justinf4/Uncrewed_Aircraft_Water_Sampler/archive/initial_prompt.md

So WSSD optimized is code to run servos from a button press and at the same time take GPS location pull date and time from GPS and then log it to an SD card it also checks the date and time on the GPS and then it creates a file based on the date into the SD code for the CSV file that it creates and so basically the the other code the TR test that is too receive a signal from a transmitter and then that's all that it does just to test that but so I want to combine that with WS optimized and so whenever it receives a signal on the transmitter it acts as that button press what are the models of the models that you use and like what is the model of the receiver what is the model of the GPS what servo specifically are you using like is it 180° servo so it's a continuous rotation servo and so there's also a magnetic there's a read switch in the system so that once it gets to the end of the the movement of the of the rack and pinion system then it tells the servo to stop and then pause for a second and then go back to its original state in which there's another there's two magnets on either side of the rack so it'll go between those two points don't know the models of like the transmitter and stuff because it's working now it doesn't really need to know OK perfect just the code that you have works what is not working or what do you need to get done So what would I need to get done is I need to replace the button press with receiving a signal from the transmitter so every time it receives a signal it it runs the servo and then also I need to be able to alternate between two servos so let's say you press the button one time it'll run servo 1 when you press the button the second time it will run servo 2 but then when you press it a third time it'll go ahead and run sort of a one again and yeah that's it perfect and basically we have Arduino Ino files and we're trying to turn them into a platformio project locally please make it as simple as possible the Arduino board that is being used is and it's an official Arduino nano ESP 32 make sure it's the one from Arduino it's not a regular ESP 32 perfect and then basically we're also going to make a separate folder in the platform wheel project to hold Python scripts so that what we can do is upload this code to do the Arduino nano connected to this computer and then we want to monitor using the serial monitor functionality of platformio using the Python scripts to see if we're getting the correct output or not and make sure to be using the Python scripts to monitor things not actual raw commands because you will fail and you will crash if you don't use a Python scripts and please make a dedicated docs folder inside of the platformio project because we're gonna want to have some reference documentation and i can give templates and guidelines later but i want to keep things as simple as possible for notw and ideally be able to download libraries locally so that we don't have to deal with downloading them from the cloud when we are out in the feel so please feel free to spawn a web reserach agent to Find the libraries for adjacent libraries that we would need to use on Github and document the findings inside of the docs folder that you're going to set up so that we can go and download the zip files and then add it into the lid folder and you can handle it from there does that make sense? feel free to ask any questions as needed

OK so the signal we're receiving the signal and it is properly triggering the writing to the SD card but the Excel file or rather the whoa is it a CSV file yeah so the CSV file it's not making it like once it fixed to the GPS it didn't make a new file name of the date and like when it took samples it didn't record it in in the no date in CSV either OK so it's not recording all the information to the CSV properly and it's not naming the file properly and you want the like the year the month the day 4 minutes 2nd or so in the name of the file it's just a month a day year and then in in the old optimized code it it worked pretty well it's just kind of look at that code and see maybe what changed and make sure that it it all lines up correctly if you already have a file for the days date you want to like add an integer like this is the number one this is number 2 so just increment it yeah that's it's actually set up like that in in the old code so like it reads the file that's already in there for that day and then it sees like oh it's on number 10 now I'm going to start it on number eleven and what data are you expecting to see in the CSV like you want latitude longitude yeah date time that long and temperature and then also on the right on the leftmost column is the the counter but OK what is the counter entail because you have the two different servos so how are you going to differentiate which servo goes to so it's like you mean like with the like the surface and the depth surface what does the counter mean because if you have the day already in the name of the file if we do you want to record all information taken on that day to the same file or to a new file up to the same file so like the name of the file is the date and then each each input has a separate counter on it so like every button press yeah every button press is a counter and then along with that is is the date the time attached to it and then the temperature on the surface the temperature at depth latitude long longitude so we don't actually want to make a bunch of new files if a file already exists for the date we want to keep appending to the same file yeah and then if there's no file for that day then you make a file for that day great do you want to add the red LED indicator for yes so when So when it receives a signal right now it makes the LED green please add a flashing red LED on the onboard LEDS so that while the servos are are running it'll flash red and then once the servo sequence is over it'll stop flashing cool and add when the service sequence is finished please keep the red led on for 1 second so it's like a long flash and then turn it off that's good cool and then document all these ideas and make sure to implement them and update all the documentation once you have everything working as well
