justinf4/Uncrewed_Aircraft_Water_Sampler/docs/wiring schematic/UAWS_SCHEMATIC_REV_B_WHITE.pdf

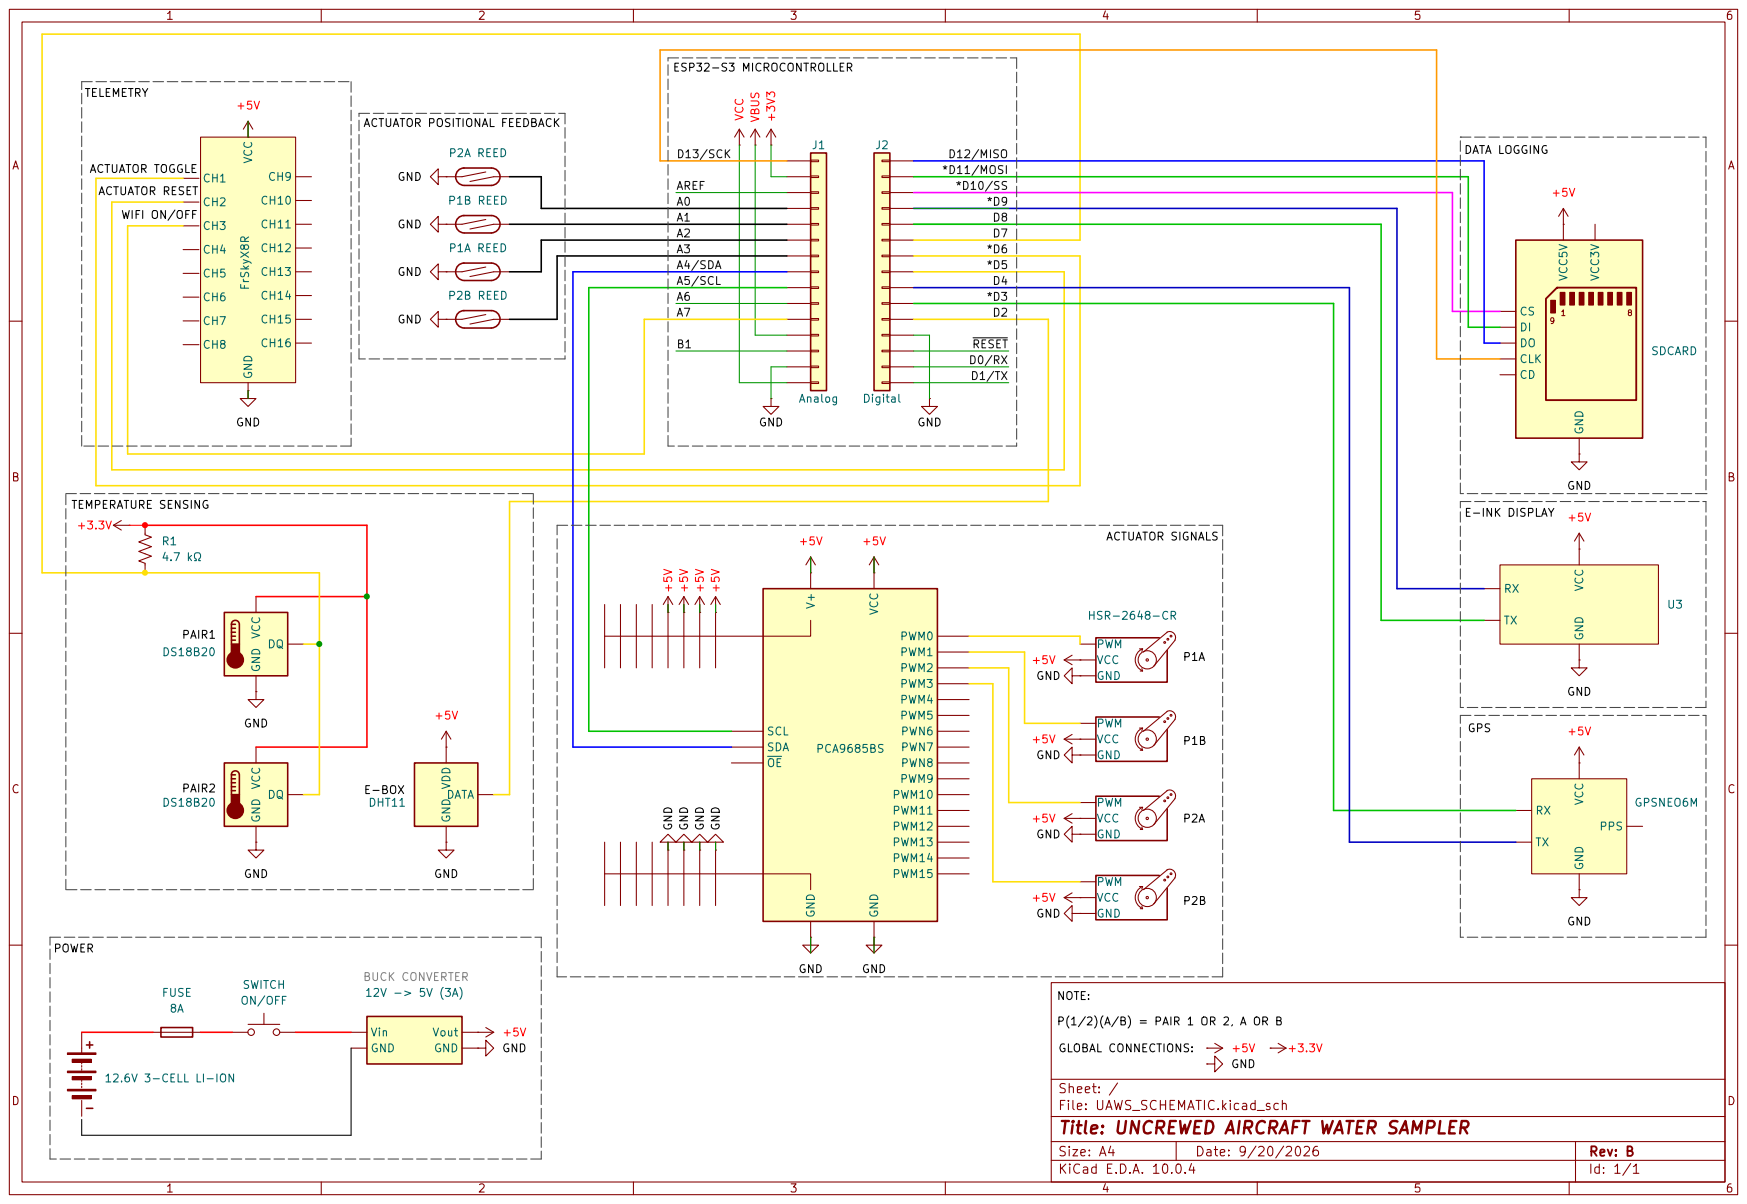
[picture p2: page 1]
