justinf4/Uncrewed_Aircraft_Water_Sampler/src/main_driver_v6.cpp

// ── main_driver_v7.cpp ────────────────────────────────────────────────────────
#include <Wire.h>
#include <Adafruit_PWMServoDriver.h>
#include <TinyGPSPlus.h>
#include <OneWire.h>
#include <DallasTemperature.h>
#include <SD.h>
#include <SPI.h>
#include <dht11.h>
#include <WiFi.h>
#include <WebServer.h>
#include <ESPmDNS.h>

// ── Pins ──────────────────────────────────────
const int SD_CS_PIN    = D10;
const int RECEIVER_PIN = D6;
const int RESET_PIN    = D5;
const int WIFI_PIN     = A7;

const int REED1 = A2;
const int REED2 = A1;
const int REED3 = A0;
const int REED4 = A3;

const int DISP_TX_PIN = D8;
const int DISP_RX_PIN = D9;

const uint8_t CH_S1 = 2, CH_S2 = 1, CH_S3 = 0, CH_S4 = 3;

const int OPEN  = 1000;
const int CLOSE = 2000;
const int STOP  = 1491;

const unsigned long PAUSE_TIME        = 2000;
const unsigned long MAG_IGNORE_TIME   = 2000;
const unsigned long MAX_MOVE_TIME     = 30000;
const unsigned long LED_FLASH_MS      = 150;
const uint32_t      TRIGGER_THRESHOLD = 1800;

// ── WiFi / AP ─────────────────────────────────
const char* AP_SSID = "UAWSampler";
const char* AP_PASS = "uaws1234";

// A7 carries a standard RC PWM signal (1000-2000 us, 50 Hz frame).
// We use pulseIn with a full 25 ms timeout so it always catches the pulse
// regardless of where in the 20 ms frame it is called.
// We only call it every 500 ms, so a 25 ms block is only 5% loop duty.
// A 3-of-5 majority vote across consecutive readings rejects one-shot
// noise spikes (e.g. from servo motor switching transients).
const uint32_t      WIFI_PULSE_TIMEOUT  = 25000; // us - full RC frame
const unsigned long WIFI_CHECK_INTERVAL = 500;   // ms between pulseIn calls

Adafruit_PWMServoDriver pwm = Adafruit_PWMServoDriver();

OneWire oneWire(10);
DallasTemperature sensors(&oneWire);
DeviceAddress SURFACE_ADDR = { 0x28, 0x9C, 0xEB, 0x6F, 0x00, 0x00, 0x00, 0x72 };
DeviceAddress DEPTH_ADDR   = { 0x28, 0x7A, 0x7A, 0x74, 0x00, 0x00, 0x00, 0x3F };

HardwareSerial gpsSerial(2);
TinyGPSPlus gps;
HardwareSerial dispSerial(1);

WebServer webServer(80);
bool wifiActive   = false;

// ── WiFi switch non-blocking state ────────────
// A7 carries a PWM signal from the RC receiver.
bool          lastWifiHigh      = false;
unsigned long lastWifiCheckMs   = 0;
// 3-of-5 vote buffer — stores last 5 raw pulse readings
uint32_t      wifiVoteBuf[5]    = {0, 0, 0, 0, 0};
uint8_t       wifiVoteIdx       = 0;
uint32_t      wifiLastPulse     = 0; // last raw pulse us (logged in heartbeat)

// ── DHT11 ─────────────────────────────────────
#define DHT11PIN D2
dht11 DHT11;
unsigned long lastTempRead = 0;
float ambientTemp          = 23.0f;
int   dynSTOP              = 1491;
int   dynOPEN              = 1000;
int   dynCLOSE             = 2000;

// ── Servo pairs ───────────────────────────────
struct ServoPair { uint8_t chA; int reedA; uint8_t chB; int reedB; };
ServoPair pairs[2] = {
    { CH_S1, REED1, CH_S2, REED2 },
    { CH_S3, REED3, CH_S4, REED4 }
};

struct SnapData { bool valid, hasFix; char date[12]; double lat, lng; };

int           pairMode[2]       = {0, 0};
bool          pairStoppedA[2]   = {false, false};
bool          pairStoppedB[2]   = {false, false};
unsigned long pairPrevMillis[2] = {0, 0};
SnapData      pairSnap[2];

// ── Last sample ───────────────────────────────
struct LastSample {
    bool   valid;
    int    count;
    char   date[12];
    char   time[10];
    bool   hasFix;
    double lat, lng;
    float  surfaceTemp;
    float  depthTemp;
    float  ambientAtSample;
} lastSample = {false};

// ── Display state ─────────────────────────────
int  sampleCount  = 0;
int  displayNumA  = 1;
int  displayNumB  = 2;
bool displayFullA = false;
bool displayFullB = false;
int  servoIndex   = 0;
int  pairSlot[2]  = {0, 1};

bool          sentFull[2]        = {false, false};
bool          pairModeEntered[2] = {false, false};
unsigned long lastHeartbeat      = 0;
unsigned long ledGreenOffAt      = 0;
unsigned long ledRedOffAt        = 0;
unsigned long ledFlashNext       = 0;
bool          ledRedState        = false;
bool          ledBlueState       = false;   // tracks blue LED so we can flash/set it cleanly
bool          lastReceiverHigh   = false;
bool          lastResetHigh      = false;
bool          fixAnnounced       = false;
bool          lastFixState       = false;
char          logFilename[20]    = "/nodate.csv";

// ── Web UI CSS ────────────────────────────────
static const char* CSS = R"(
  *{box-sizing:border-box;margin:0;padding:0;}
  body{font-family:'Courier New',Courier,monospace;background:#d4d0c8;color:#000;font-size:13px;}
  .hdr{background:linear-gradient(90deg,#000080,#1084d0);padding:10px 14px 8px;
       border-bottom:2px solid #ffcc00;}
  .hdr h1{color:#fff;font-size:13px;font-weight:700;letter-spacing:0.5px;margin:0;line-height:1.3;}
  .hdr p{color:#ffcc00;font-size:10px;margin:2px 0 0;letter-spacing:0.5px;}
  .body{padding:12px;}
  .stats{display:grid;grid-template-columns:1fr 1fr;gap:8px;margin-bottom:10px;}
  .stat{background:#fff;padding:10px;text-align:center;
        border:1px solid;border-color:#fff #808080 #808080 #fff;}
  .stat-num{font-size:26px;font-weight:700;color:#000080;}
  .stat-lbl{font-size:9px;color:#555;text-transform:uppercase;letter-spacing:0.5px;margin-top:2px;}
  .card{background:#fff;padding:10px 12px;margin-bottom:10px;
        border:1px solid;border-color:#fff #808080 #808080 #fff;}
  .card-title{font-size:9px;color:#000080;text-transform:uppercase;letter-spacing:1px;
              font-weight:700;border-bottom:1px solid #000080;padding-bottom:3px;margin-bottom:8px;}
  .row{display:flex;justify-content:space-between;align-items:center;
       padding:5px 0;border-bottom:1px solid #d4d0c8;font-size:11px;}
  .row:last-child{border-bottom:none;padding-bottom:0;}
  .rl{color:#555;}
  .rv{font-weight:700;color:#000;}
  .badge{display:inline-block;padding:2px 8px;font-size:9px;font-weight:700;
         border:1px solid #000080;color:#000080;background:#fff;letter-spacing:0.5px;}
  .badge-gold{background:#ffcc00;color:#000080;border:1px solid #cc9900;}
  .badge-navy{background:#000080;color:#ffcc00;border:1px solid #000060;}
  .badge-gray{background:#d4d0c8;color:#555;border:1px solid #808080;}
  .badge-amber{background:#b87800;color:#fff;border:1px solid #8a5a00;}
  .dl-btn{display:flex;align-items:center;justify-content:center;gap:8px;width:100%;
          background:#000080;color:#ffcc00;padding:13px;font-size:14px;font-weight:700;
          text-decoration:none;font-family:inherit;letter-spacing:0.5px;
          border:1px solid;border-color:#1060c0 #00004a #00004a #1060c0;margin-bottom:8px;}
  .dl-btn-disabled{background:#808080;color:#d4d0c8;border-color:#606060 #404040 #404040 #606060;
                   pointer-events:none;}
  .outline-btn{display:block;text-align:center;padding:11px;
               border:1px solid;border-color:#fff #808080 #808080 #fff;
               background:#d4d0c8;color:#000080;font-size:13px;font-weight:700;
               text-decoration:none;font-family:inherit;letter-spacing:0.5px;}
  .hint{text-align:center;font-size:10px;color:#808080;margin-top:6px;}
  .back-row{display:flex;align-items:center;gap:10px;}
  .back-arrow{color:#ffcc00;font-size:18px;font-weight:700;text-decoration:none;}
  .file-list{border:1px solid;border-color:#fff #808080 #808080 #fff;overflow:hidden;}
  .file-row{display:flex;justify-content:space-between;align-items:center;
            padding:11px 14px;border-bottom:1px solid #d4d0c8;
            text-decoration:none;color:#000;background:#fff;font-size:12px;}
  .file-row:nth-child(even){background:#f0f0f0;}
  .file-row:last-child{border-bottom:none;}
  .fn{font-weight:700;color:#000;}
  .fn-active{color:#000080;}
  .active-pill{font-size:9px;background:#ffcc00;color:#000080;padding:1px 6px;
               font-weight:700;margin-left:6px;border:1px solid #cc9900;}
  .dl-arrow{color:#000080;font-size:16px;font-weight:700;}
  .empty{text-align:center;padding:30px;color:#555;font-size:13px;}
)";

// ── Forward declarations ───────────────────────
void startWiFiServer();
void stopWiFiServer();

// ── LED helper ────────────────────────────────
// All three channels on XIAO ESP32-S3 built-in RGB are active-LOW.
void ledSet(int pin, bool on) { digitalWrite(pin, on ? LOW : HIGH); }

// ── Display send ──────────────────────────────
void sendDisplay() {
    const char* fname = (logFilename[0] == '/') ? logFilename + 1 : logFilename;
    dispSerial.printf("DISP,%d,%s,%d,%s,%s,%s,%.1f\n",
        displayNumA, displayFullA ? "FULL" : "EMPTY",
        displayNumB, displayFullB ? "FULL" : "EMPTY",
        fixAnnounced ? "FIXED" : "NOFIXED",
        fname, ambientTemp);
    Serial.printf("[DISP] A=%d/%s B=%d/%s GPS=%s file=%s temp=%.1fC\n",
        displayNumA, displayFullA?"FULL":"EMPTY",
        displayNumB, displayFullB?"FULL":"EMPTY",
        fixAnnounced?"FIXED":"NOFIXED", fname, ambientTemp);
}

// ── Servo helper ──────────────────────────────
void servoWrite(uint8_t ch, int us) { pwm.writeMicroseconds(ch, us); }

// ── GPS helpers ───────────────────────────────
void feedGPS(unsigned long ms) {
    unsigned long s = millis();
    while (millis() - s < ms) while (gpsSerial.available()) gps.encode(gpsSerial.read());
}

// pulseInWithGPS — drop-in replacement for pulseIn on RC channels.
// Drains the GPS serial buffer before AND after the blocking pulseIn call
// so that up to 25 ms of blocking never causes a GPS sentence to be lost.
// At 9600 baud a full NMEA sentence is ~73 ms; the 256-byte hardware buffer
// holds ~26 ms of data, so draining every 25 ms keeps us safe.
uint32_t pulseInWithGPS(int pin, uint8_t state, uint32_t timeout) {
    while (gpsSerial.available()) gps.encode(gpsSerial.read());
    uint32_t result = pulseIn(pin, state, timeout);
    while (gpsSerial.available()) gps.encode(gpsSerial.read());
    return result;
}
static int daysInMonth(int m, int y) {
    const int d[] = {31,28,31,30,31,30,31,31,30,31,30,31};
    if (m==2 && ((y%4==0&&y%100!=0)||y%400==0)) return 29;
    return d[m-1];
}
static int dayOfWeek(int y, int m, int d) {
    static const int t[] = {0,3,2,5,0,3,5,1,4,6,2,4};
    if (m<3) y--;
    return (y+y/4-y/100+y/400+t[m-1]+d)%7;
}
static int nthWeekday(int n, int dow, int m, int y) {
    int first = dayOfWeek(y, m, 1);
    return 1+((dow-first+7)%7)+(n-1)*7;
}
static int getOffset(int utcYear, int utcMonth, int utcDay, int utcHour) {
    int dstStart = nthWeekday(2,0,3,utcYear);
    int dstEnd   = nthWeekday(1,0,11,utcYear);
    bool afterStart = (utcMonth>3)||(utcMonth==3&&utcDay>dstStart)||
                      (utcMonth==3&&utcDay==dstStart&&utcHour>=7);
    bool beforeEnd  = (utcMonth<11)||(utcMonth==11&&utcDay<dstEnd)||
                      (utcMonth==11&&utcDay==dstEnd&&utcHour<6);
    return (afterStart&&beforeEnd) ? -4 : -5;
}
bool localComponents(int* yr, int* mo, int* dy, int* hr, int* mn, int* sc) {
    if (!gps.date.isValid()||!gps.time.isValid()) return false;
    int utcHour = (int)gps.time.hour();
    int offset  = getOffset((int)gps.date.year(),(int)gps.date.month(),
                             (int)gps.date.day(),utcHour);
    *hr=utcHour+offset; *mn=(int)gps.time.minute();
    *sc=(int)gps.time.second(); *yr=(int)gps.date.year();
    *mo=(int)gps.date.month();  *dy=(int)gps.date.day();
    if (*hr<0) {
        *hr+=24; (*dy)--;
        if (*dy<1) { (*mo)--; if (*mo<1){*mo=12;(*yr)--;} *dy=daysInMonth(*mo,*yr); }
    }
    return true;
}
void dateStr(char* buf) {
    int yr,mo,dy,hr,mn,sc;
    if (localComponents(&yr,&mo,&dy,&hr,&mn,&sc))
        sprintf(buf,"%02d/%02d/%04d",mo,dy,yr);
    else if (gps.date.isValid())
        sprintf(buf,"%02d/%02d/%04d",gps.date.month(),gps.date.day(),gps.date.year());
    else
        strcpy(buf,"--/--/----");
}
void estStr(char* buf) {
    int yr,mo,dy,hr,mn,sc;
    if (localComponents(&yr,&mo,&dy,&hr,&mn,&sc))
        sprintf(buf,"%02d:%02d:%02d",hr,mn,sc);
    else
        strcpy(buf,"--:--:--");
}
void logGPS(const char* label) {
    feedGPS(100);
    char d[12],t[10]; dateStr(d); estStr(t);
    Serial.printf("[GPS] %s | %s %s EST | ",label,d,t);
    if (gps.location.isValid())
        Serial.printf("LAT=%.6f LNG=%.6f ALT=%.1f\n",
            gps.location.lat(),gps.location.lng(),gps.altitude.meters());
    else Serial.println("NO FIX");
}

// ── Temp compensation ─────────────────────────
void updateTempComp(float temp) {
    float stopVal = -5.05f * temp + 1610.0f;
    float shift   = stopVal - 1491.0f;
    dynSTOP  = (int)constrain(stopVal,         1200.0f, 1560.0f);
    dynOPEN  = (int)constrain(1000.0f + shift,  800.0f, 1300.0f);
    dynCLOSE = (int)constrain(2000.0f + shift, 1000.0f, 2500.0f);
    Serial.printf("[COMP] %.1fC → STOP=%d OPEN=%d CLOSE=%d\n",
        temp, dynSTOP, dynOPEN, dynCLOSE);
    if (temp >= 50.0f) {
        Serial.printf("[THERMAL] WARNING %.1fC >= 50C\n", temp);
        dispSerial.printf("DISP,0,EMPTY,0,EMPTY,%.1f,OVERHEAT\n", temp);
    }
}

// ── SD helpers ────────────────────────────────
void initLogFile(const char* filename) {
    strcpy(logFilename, filename);
    if (!SD.exists(logFilename)) {
        File f = SD.open(logFilename, FILE_WRITE);
        if (f) {
            f.println("Count,Date,Time_EST,Lat,Long,SurfaceTemp_C,DepthTemp_C");
            f.close();
        }
        sampleCount = 0;
    } else {
        File f = SD.open(logFilename, FILE_READ);
        int lines = 0;
        if (f) { while (f.available()) { if (f.read()=='\n') lines++; } f.close(); }
        sampleCount = max(0, lines-1);
    }
    displayNumA  = sampleCount + 1;
    displayNumB  = sampleCount + 2;
    displayFullA = false;
    displayFullB = false;
    servoIndex   = 0;
    pairSlot[0]  = 0;
    pairSlot[1]  = 1;
    Serial.printf("[SD] %s  samples=%d  display A=%d B=%d\n",
        logFilename, sampleCount, displayNumA, displayNumB);
    sendDisplay();
}

void writeSDRow(float surfaceTemp, float depthTemp, int pairIdx) {
    SnapData& snap = pairSnap[pairIdx];
    if (!SD.exists(logFilename)) {
        File hdr = SD.open(logFilename, FILE_WRITE);
        if (hdr) {
            hdr.println("Count,Date,Time_EST,Lat,Long,SurfaceTemp_C,DepthTemp_C");
            hdr.close();
        } else { Serial.println("[SD] ERROR opening for header"); return; }
    }
    File f = SD.open(logFilename, FILE_APPEND);
    if (!f) { Serial.println("[SD] ERROR opening for append"); return; }
    float st = isnan(surfaceTemp) ? 0.0f : surfaceTemp;
    float dt = isnan(depthTemp)   ? 0.0f : depthTemp;
    char ts[10]; estStr(ts);
    int csvCount = (pairSlot[pairIdx]==0) ? displayNumA : displayNumB;
    f.print(csvCount);   f.print(",");
    f.print(snap.date);  f.print(",");
    f.print(ts);         f.print(",");
    if (snap.hasFix) { f.print(snap.lat,6); f.print(","); f.print(snap.lng,6); }
    else             { f.print("NO FIX,NO FIX"); }
    f.print(","); f.print(st,2); f.print(","); f.println(dt,2);
    f.close();
    if (csvCount > sampleCount) sampleCount = csvCount;
    Serial.printf("[SD] Wrote row count=%d (pair %d slot %s)\n",
        csvCount, pairIdx+1, pairSlot[pairIdx]==0?"A":"B");

    lastSample.valid           = true;
    lastSample.count           = csvCount;
    strncpy(lastSample.date,   snap.date, 11); lastSample.date[11] = '\0';
    estStr(lastSample.time);
    lastSample.hasFix          = snap.hasFix;
    lastSample.lat             = snap.lat;
    lastSample.lng             = snap.lng;
    lastSample.surfaceTemp     = isnan(surfaceTemp) ? 0.0f : surfaceTemp;
    lastSample.depthTemp       = isnan(depthTemp)   ? 0.0f : depthTemp;
    lastSample.ambientAtSample = ambientTemp;
}

// ── File manager UART handlers ─────────────────
void handleFLIST() {
    if (!SD.exists(logFilename)) { dispSerial.println("FDONE,0"); return; }
    File f = SD.open(logFilename, FILE_READ);
    if (!f)                      { dispSerial.println("FDONE,0"); return; }
    int rowCount = 0; bool firstLine = true;
    char lineBuf[100]; uint8_t lpos = 0;
    while (f.available()) {
        char c = f.read();
        if (c=='\n'||c=='\r') {
            if (lpos > 0) {
                lineBuf[lpos] = '\0';
                if (firstLine) { firstLine = false; }
                else { dispSerial.print("FROW,"); dispSerial.println(lineBuf); rowCount++; }
                lpos = 0;
            }
        } else { if (lpos<99) lineBuf[lpos++] = c; }
    }
    f.close();
    dispSerial.printf("FDONE,%d\n", rowCount);
    Serial.printf("[FM] Sent %d rows\n", rowCount);
}

void handleFDEL(int targetCount) {
    if (!SD.exists(logFilename)) { dispSerial.println("FDEL_ERR"); return; }
    File f = SD.open(logFilename, FILE_READ);
    if (!f) { dispSerial.println("FDEL_ERR"); return; }
    const int MAXLINES = 210;
    static char lines[MAXLINES][100];
    int lineCount = 0; char lineBuf[100]; uint8_t lpos = 0;
    while (f.available() && lineCount < MAXLINES) {
        char c = f.read();
        if (c=='\n'||c=='\r') {
            if (lpos > 0) {
                lineBuf[lpos] = '\0';
                strncpy(lines[lineCount++], lineBuf, 99);
                lpos = 0;
            }
        } else { if (lpos<99) lineBuf[lpos++] = c; }
    }
    f.close();
    SD.remove(logFilename);
    File out = SD.open(logFilename, FILE_WRITE);
    if (!out) { dispSerial.println("FDEL_ERR"); return; }
    bool deleted = false;
    for (int i = 0; i < lineCount; i++) {
        if (i == 0) { out.println(lines[i]); }
        else if (atoi(lines[i]) == targetCount) { deleted = true; }
        else { out.println(lines[i]); }
    }
    out.close();
    dispSerial.println(deleted ? "FDEL_OK" : "FDEL_ERR");
    Serial.printf("[FM] %s row %d\n", deleted?"Deleted":"Not found", targetCount);
}

void handleFWIPE() {
    SD.remove(logFilename);
    File f = SD.open(logFilename, FILE_WRITE);
    if (!f) { dispSerial.println("FWIPE_ERR"); return; }
    f.println("Count,Date,Time_EST,Lat,Long,SurfaceTemp_C,DepthTemp_C");
    f.close();
    sampleCount      = 0;
    displayNumA      = 1; displayFullA = false;
    displayNumB      = 2; displayFullB = false;
    servoIndex       = 0;
    pairSlot[0]      = 0; pairSlot[1]  = 1;
    lastSample.valid = false;
    sendDisplay();
    dispSerial.println("FWIPE_OK");
    Serial.printf("[FM] Wiped %s\n", logFilename);
}

// ── WiFi server ───────────────────────────────
void startWiFiServer() {
    // FIX: set mode explicitly before softAP so radio is fully on
    WiFi.mode(WIFI_AP);
    delay(100);
    WiFi.softAP(AP_SSID, AP_PASS);
    delay(100);
    MDNS.begin("uaws");
    Serial.printf("[WIFI] AP: %s  IP: %s\n", AP_SSID, WiFi.softAPIP().toString().c_str());

    // ── Root page ─────────────────────────────
    webServer.on("/", []() {
        bool sampling = (pairMode[0] > 0 || pairMode[1] > 0);
        const char* fn = (logFilename[0]=='/') ? logFilename+1 : logFilename;
        char timeStr[10]; estStr(timeStr);
        char gpsStr[32];
        if (fixAnnounced && gps.location.isValid())
            snprintf(gpsStr, sizeof(gpsStr), "%.5f, %.5f",
                gps.location.lat(), gps.location.lng());
        else
            snprintf(gpsStr, sizeof(gpsStr), "No fix");

        String html = F("<!DOCTYPE html><html><head>"
            "<meta name='viewport' content='width=device-width,initial-scale=1'>"
            "<meta http-equiv='refresh' content='10'>"
            "<style>");
        html += CSS;
        html += F("</style></head><body>");

        html += F("<div class='hdr'>"
                  "<h1>Uncrewed Aircraft Water Sampler</h1>"
                  "<p>192.168.4.1 &bull; uaws.local</p>"
                  "</div><div class='body'>");

        html += F("<div class='stats'><div class='stat'><div class='stat-num'>");
        html += String(sampleCount);
        html += F("</div><div class='stat-lbl'>Samples</div></div>"
                  "<div class='stat'><div class='stat-num'>");
        html += String((int)roundf(ambientTemp));
        html += F("&deg;</div><div class='stat-lbl'>Box temp C</div></div></div>");

        html += F("<div class='card'><div class='card-title'>Status</div>");
        html += F("<div class='row'><span class='rl'>Active file</span><span class='rv'>");
        html += fn;
        html += F("</span></div>");
        html += F("<div class='row'><span class='rl'>GPS</span><span>");
        html += fixAnnounced
            ? F("<span class='badge badge-gold'>Fixed</span>")
            : F("<span class='badge badge-gray'>No fix</span>");
        html += F("</span></div>");
        html += F("<div class='row'><span class='rl'>Location</span>"
                  "<span class='rv' style='font-size:10px;'>");
        html += gpsStr;
        html += F("</span></div>");
        html += F("<div class='row'><span class='rl'>Time (EST)</span><span class='rv'>");
        html += timeStr;
        html += F("</span></div>");
        html += F("<div class='row'><span class='rl'>Sampling</span><span>");
        html += sampling
            ? F("<span class='badge badge-amber'>Active</span>")
            : F("<span class='badge'>Idle</span>");
        html += F("</span></div></div>");

        if (lastSample.valid) {
            html += F("<div class='card'><div class='card-title'>Last Sample</div>");
            char countStr[8];
            snprintf(countStr, sizeof(countStr), "#%d", lastSample.count);
            html += F("<div class='row'><span class='rl'>Sample</span>"
                      "<span class='badge badge-navy'>");
            html += countStr;
            html += F("</span></div>");
            html += F("<div class='row'><span class='rl'>Date</span><span class='rv'>");
            html += lastSample.date;
            html += F("</span></div>");
            html += F("<div class='row'><span class='rl'>Time (EST)</span><span class='rv'>");
            html += lastSample.time;
            html += F("</span></div>");
            html += F("<div class='row'><span class='rl'>GPS</span><span>");
            if (lastSample.hasFix) {
                char coordStr[32];
                snprintf(coordStr, sizeof(coordStr), "%.5f, %.5f",
                    lastSample.lat, lastSample.lng);
                html += F("<span class='rv' style='font-size:10px;'>");
                html += coordStr;
                html += F("</span>");
            } else {
                html += F("<span class='badge badge-gray'>No fix</span>");
            }
            html += F("</span></div>");
            char surfStr[12], depStr[12], ambStr[12];
            snprintf(surfStr, sizeof(surfStr), "%.2f C", lastSample.surfaceTemp);
            snprintf(depStr,  sizeof(depStr),  "%.2f C", lastSample.depthTemp);
            snprintf(ambStr,  sizeof(ambStr),  "%.1f C", lastSample.ambientAtSample);
            html += F("<div class='row'><span class='rl'>Surface temp</span>"
                      "<span class='rv'>");
            html += surfStr;
            html += F("</span></div>");
            html += F("<div class='row'><span class='rl'>Depth temp</span>"
                      "<span class='rv'>");
            html += depStr;
            html += F("</span></div>");
            html += F("<div class='row'><span class='rl'>Box temp</span>"
                      "<span class='rv'>");
            html += ambStr;
            html += F("</span></div></div>");
        }

        html += F("<div class='card'><div class='card-title'>Download</div>");
        if (sampling) {
            html += F("<a class='dl-btn dl-btn-disabled'>&#8595; Sampling in progress...</a>");
        } else {
            html += F("<a class='dl-btn' href='/download'>&#8595; Download active file</a>");
        }
        html += F("<a class='outline-btn' href='/files'>Browse all files on SD card</a>");
        html += F("</div>");
        html += F("<p class='hint'>Page refreshes every 10s</p>");
        html += F("</div></body></html>");

        webServer.send(200, "text/html", html);
    });

    // ── File browser ──────────────────────────
    webServer.on("/files", []() {
        String html = F("<!DOCTYPE html><html><head>"
            "<meta name='viewport' content='width=device-width,initial-scale=1'>"
            "<style>");
        html += CSS;
        html += F("</style></head><body>");
        html += F("<div class='hdr'><div class='back-row'>"
                  "<a class='back-arrow' href='/'>&#8592;</a>"
                  "<div><h1>SD Card Files</h1>"
                  "<p>Uncrewed Aircraft Water Sampler</p>"
                  "</div></div></div><div class='body'>");

        File root = SD.open("/");
        bool found = false;
        if (root) {
            html += F("<div class='file-list'>");
            File entry = root.openNextFile();
            while (entry) {
                String name = String(entry.name());
                if (!entry.isDirectory() && name.endsWith(".csv")) {
                    found = true;
                    bool isActive = (String("/") + name == String(logFilename));
                    html += F("<a class='file-row' href='/download?f=");
                    html += name;
                    html += F("'><span><span class='fn");
                    if (isActive) html += F(" fn-active");
                    html += F("'>");
                    html += name;
                    html += F("</span>");
                    if (isActive) html += F("<span class='active-pill'>active</span>");
                    html += F("</span><span class='dl-arrow'>&#8595;</span></a>");
                }
                entry.close();
                entry = root.openNextFile();
            }
            root.close();
            if (!found)
                html += F("<p class='empty'>No CSV files found on SD card</p>");
            html += F("</div>");
        } else {
            html += F("<p class='empty'>Could not read SD card</p>");
        }

        html += F("</div></body></html>");
        webServer.send(200, "text/html", html);
    });

    // ── Download ──────────────────────────────
    webServer.on("/download", []() {
        if (pairMode[0] > 0 || pairMode[1] > 0) {
            webServer.send(503, "text/plain", "Sampling in progress - try again shortly");
            return;
        }
        String targetFile;
        if (webServer.hasArg("f")) {
            targetFile = "/" + webServer.arg("f");
        } else {
            targetFile = String(logFilename);
        }
        if (!targetFile.endsWith(".csv") || targetFile.indexOf("..") >= 0) {
            webServer.send(400, "text/plain", "Invalid file");
            return;
        }
        if (!SD.exists(targetFile.c_str())) {
            webServer.send(404, "text/plain", "File not found");
            return;
        }
        File f = SD.open(targetFile.c_str(), FILE_READ);
        if (!f) { webServer.send(500, "text/plain", "Open failed"); return; }
        String dlName = targetFile.substring(1);
        webServer.sendHeader("Content-Disposition",
            "attachment; filename=" + dlName);
        webServer.streamFile(f, "text/csv");
        f.close();
        Serial.printf("[WIFI] Served: %s\n", targetFile.c_str());
    });

    // ── Status JSON ───────────────────────────
    webServer.on("/status", []() {
        char json[200];
        char timeStr[10]; estStr(timeStr);
        snprintf(json, sizeof(json),
            "{\"samples\":%d,\"gps\":%s,\"temp\":%.1f,\"file\":\"%s\","
            "\"sampling\":%s,\"time\":\"%s\"}",
            sampleCount,
            fixAnnounced ? "true" : "false",
            ambientTemp,
            (logFilename[0]=='/') ? logFilename+1 : logFilename,
            (pairMode[0]>0||pairMode[1]>0) ? "true" : "false",
            timeStr);
        webServer.send(200, "application/json", json);
    });

    webServer.begin();
    wifiActive = true;

    // FIX: drive LEDB directly — same active-LOW logic as LEDG/LEDR
    ledBlueState = true;
    ledSet(LEDB, true);

    dispSerial.println("WIFI_ON");
    Serial.println("[WIFI] Server started — http://uaws.local or http://192.168.4.1");
}

void stopWiFiServer() {
    webServer.stop();
    MDNS.end();
    WiFi.softAPdisconnect(true);

    // FIX: fully power down the radio so no SSID is visible on any device
    WiFi.mode(WIFI_OFF);

    wifiActive = false;

    // FIX: turn off blue LED
    ledBlueState = false;
    ledSet(LEDB, false);

    dispSerial.println("WIFI_OFF");
    Serial.println("[WIFI] Stopped — radio off");
}

// ── WiFi switch — pulseIn + 3-of-5 majority vote ─────────────────────────
// Called every 500 ms from loop(). pulseIn blocks up to 25 ms — acceptable.
// The vote buffer means 3 consecutive noise spikes (1500 ms) would be needed
// to falsely trigger; a real switch flip registers within ~1.5 seconds.
void checkWifiSwitch() {
    uint32_t pulse = pulseInWithGPS(WIFI_PIN, HIGH, WIFI_PULSE_TIMEOUT);
    wifiLastPulse  = pulse;

    // Store reading in circular vote buffer
    wifiVoteBuf[wifiVoteIdx] = pulse;
    wifiVoteIdx = (wifiVoteIdx + 1) % 5;

    // Count how many of the last 5 readings were above threshold
    int votes = 0;
    for (int i = 0; i < 5; i++)
        if (wifiVoteBuf[i] > TRIGGER_THRESHOLD) votes++;

    // Require 3-of-5 to change state (majority, noise-resistant)
    bool wifiHigh;
    if      (votes >= 3) wifiHigh = true;
    else if (votes <= 2) wifiHigh = false;
    else                 wifiHigh = lastWifiHigh; // shouldn't reach here with 5 samples

    if (wifiHigh && !lastWifiHigh) {
        Serial.printf("[WIFI] Switch ON  (pulse=%u votes=%d/5)\n", pulse, votes);
        if (!wifiActive) startWiFiServer();
    } else if (!wifiHigh && lastWifiHigh) {
        Serial.printf("[WIFI] Switch OFF (pulse=%u votes=%d/5)\n", pulse, votes);
        if (wifiActive) stopWiFiServer();
    }
    lastWifiHigh = wifiHigh;
}

// ── Setup ─────────────────────────────────────
void setup() {
    Serial.begin(9600);
    delay(2000);
    dispSerial.begin(9600, SERIAL_8N1, DISP_RX_PIN, DISP_TX_PIN);
    Wire.begin();
    pwm.begin();
    pwm.setOscillatorFrequency(29000000);
    pwm.setPWMFreq(50);
    delay(10);

    DHT11.read(DHT11PIN);
    ambientTemp = (float)DHT11.temperature;
    updateTempComp(ambientTemp);

    pwm.writeMicroseconds(CH_S1, dynSTOP);
    pwm.writeMicroseconds(CH_S2, dynSTOP);
    pwm.writeMicroseconds(CH_S3, dynSTOP);
    pwm.writeMicroseconds(CH_S4, dynSTOP);

    pinMode(RECEIVER_PIN, INPUT);
    pinMode(RESET_PIN,    INPUT);
    pinMode(WIFI_PIN,     INPUT);
    pinMode(REED1, INPUT_PULLUP); pinMode(REED2, INPUT_PULLUP);
    pinMode(REED3, INPUT_PULLUP); pinMode(REED4, INPUT_PULLUP);
    pinMode(LEDG, OUTPUT); ledSet(LEDG, false);
    pinMode(LEDR, OUTPUT); ledSet(LEDR, false);
    pinMode(LEDB, OUTPUT); ledSet(LEDB, false);

    // FIX: start with radio fully off so we don't broadcast before the
    // switch is checked
    WiFi.mode(WIFI_OFF);

    SPI.begin(D13, D12, D11, D10);
    if (SD.begin(SD_CS_PIN)) {
        Serial.println("[SD] Ready");
        initLogFile("/nodate.csv");
    } else {
        Serial.println("[SD] FAILED");
        sendDisplay();
    }

    delay(100);
    gpsSerial.begin(9600, SERIAL_8N1, D3, D4);
    sensors.begin();
    sensors.setResolution(SURFACE_ADDR, 12);
    sensors.setResolution(DEPTH_ADDR,   12);
    sensors.requestTemperatures();
    delay(800);
    lastFixState = fixAnnounced;

    // Seed WiFi switch state at boot — pre-fill the vote buffer with 5
    // readings so the first loop() poll doesn't see a false edge.
    // pulseIn here is fine; we're still in setup().
    for (int i = 0; i < 5; i++) {
        wifiVoteBuf[i] = pulseInWithGPS(WIFI_PIN, HIGH, WIFI_PULSE_TIMEOUT);
        delay(30); // let the RC frame cycle between readings
    }
    {
        int votes = 0;
        for (int i = 0; i < 5; i++)
            if (wifiVoteBuf[i] > TRIGGER_THRESHOLD) votes++;
        lastWifiHigh = (votes >= 3);
        wifiLastPulse = wifiVoteBuf[4];
        Serial.printf("[WIFI] Boot pulse=%u votes=%d/5 → switch %s\n",
            wifiLastPulse, votes, lastWifiHigh ? "ON" : "OFF");
        if (lastWifiHigh) startWiFiServer();
    }
    lastWifiCheckMs = millis();

    Serial.println("[SYS] driver_V7 Ready");
}

// ── UART receive ──────────────────────────────
char    dispInBuf[32];
uint8_t dispInPos = 0;

void processDispMessage(const char* msg) {
    if (strcmp(msg, "POLL")  == 0)     { sendDisplay();           return; }
    if (strcmp(msg, "FLIST") == 0)     { handleFLIST();           return; }
    if (strncmp(msg, "FDEL,", 5) == 0) { handleFDEL(atoi(msg+5)); return; }
    if (strcmp(msg, "FWIPE") == 0)     { handleFWIPE();           return; }
}

// ── Loop ──────────────────────────────────────
void loop() {

    // ── WiFi server tick ──────────────────────
    if (wifiActive) webServer.handleClient();

    // ── WiFi switch — polled every 100 ms, non-blocking ──────────────────
    // FIX: moved out of the servo-cycle gate so it works any time.
    // The 5 ms pulseIn timeout means worst-case we stall 5 ms — acceptable.
    if (millis() - lastWifiCheckMs >= WIFI_CHECK_INTERVAL) {
        lastWifiCheckMs = millis();
        checkWifiSwitch();
    }

    // ── DHT11 temp read every 5s ──────────────
    if (millis() - lastTempRead >= 5000) {
        lastTempRead = millis();
        DHT11.read(DHT11PIN);
        ambientTemp = (float)DHT11.temperature;
        updateTempComp(ambientTemp);
    }

    // ── Receive from display ──────────────────
    while (dispSerial.available()) {
        char c = dispSerial.read();
        if (c == '\n' || c == '\r') {
            if (dispInPos > 0) {
                dispInBuf[dispInPos] = '\0';
                processDispMessage(dispInBuf);
                dispInPos = 0;
            }
        } else {
            if (dispInPos < sizeof(dispInBuf)-1) dispInBuf[dispInPos++] = c;
            else dispInPos = 0;
        }
    }

    // ── GPS feed ──────────────────────────────
    while (gpsSerial.available()) gps.encode(gpsSerial.read());

    if (!fixAnnounced && gps.location.isValid() && gps.date.isValid()) {
        fixAnnounced = true;
        int yr,mo,dy,hr,mn,sc; char fname[20];
        if (localComponents(&yr,&mo,&dy,&hr,&mn,&sc))
            sprintf(fname, "/%04d%02d%02d.csv", yr, mo, dy);
        else
            sprintf(fname, "/%04d%02d%02d.csv",
                gps.date.year(), gps.date.month(), gps.date.day());
        if (strcmp(logFilename, fname) != 0) initLogFile(fname);
        else sendDisplay();
        lastFixState = true;
        Serial.println("[GPS] Fix acquired");
    }

    if (fixAnnounced != lastFixState) {
        lastFixState = fixAnnounced;
        sendDisplay();
    }

    // ── Derived flags ─────────────────────────
    bool anyActive  = (pairMode[0]>0 || pairMode[1]>0);
    bool nextIdle   = (pairMode[servoIndex]==0);
    bool anyWaiting = (pairMode[0]==3 || pairMode[1]==3);

    // ── CH1 trigger ───────────────────────────
    bool triggered = false;
    if (nextIdle) {
        uint32_t pulse   = pulseInWithGPS(RECEIVER_PIN, HIGH, 25000);
        bool recvHigh    = (pulse > TRIGGER_THRESHOLD);
        triggered        = (recvHigh && !lastReceiverHigh);
        lastReceiverHigh = recvHigh;
    } else { lastReceiverHigh = false; }

    // ── CH2 reset ─────────────────────────────
    bool resetTriggered = false;
    if (anyWaiting) {
        uint32_t resetPulse = pulseInWithGPS(RESET_PIN, HIGH, 25000);
        bool resetHigh      = (resetPulse > TRIGGER_THRESHOLD);
        resetTriggered      = (resetHigh && !lastResetHigh);
        lastResetHigh       = resetHigh;
    } else { lastResetHigh = false; }

    // ── Heartbeat ─────────────────────────────
    if (millis() - lastHeartbeat >= 5000) {
        lastHeartbeat = millis();
        char t[10]; estStr(t);
        Serial.printf("[STATUS] p0=%d p1=%d | sIdx=%d | samples=%d "
            "A=%d/%s B=%d/%s | gps=%s | temp=%.1fC | wifi=%s | blue=%s | wifiPulse=%u | %s\n",
            pairMode[0], pairMode[1], servoIndex, sampleCount,
            displayNumA, displayFullA?"F":"E",
            displayNumB, displayFullB?"F":"E",
            fixAnnounced?"FIX":"SEARCH",
            ambientTemp, wifiActive?"ON":"OFF",
            ledBlueState?"ON":"OFF", wifiLastPulse, t);
    }

    // ── Trigger: open next idle pair ──────────
    if (triggered && nextIdle) {
        int idx = servoIndex;
        pairStoppedA[idx]    = false;
        pairStoppedB[idx]    = false;
        pairPrevMillis[idx]  = millis();
        pairModeEntered[idx] = false;
        pairMode[idx]        = 1;

        feedGPS(100);
        pairSnap[idx].hasFix = gps.location.isValid();
        pairSnap[idx].lat    = pairSnap[idx].hasFix ? gps.location.lat() : 0.0;
        pairSnap[idx].lng    = pairSnap[idx].hasFix ? gps.location.lng() : 0.0;
        pairSnap[idx].valid  = true;
        dateStr(pairSnap[idx].date);

        servoIndex = 1 - servoIndex;

        ledSet(LEDG, true); ledGreenOffAt = millis() + 1000;
        if (!anyActive) ledFlashNext = millis();
        logGPS("Sample");
        Serial.printf("[TRIG] Pair %d (slot %s) opening — sample #%d\n",
            idx+1, pairSlot[idx]==0?"A":"B",
            pairSlot[idx]==0 ? displayNumA : displayNumB);
    }

    // ── Reset: close all waiting pairs ────────
    if (resetTriggered) {
        bool aFull = displayFullA;
        bool bFull = displayFullB;

        for (int i = 0; i < 2; i++) {
            if (pairMode[i] == 3) {
                pairStoppedA[i]    = false;
                pairStoppedB[i]    = false;
                pairPrevMillis[i]  = millis();
                pairModeEntered[i] = false;
                pairMode[i]        = 4;
                Serial.printf("[RESET] Closing pair %d\n", i+1);
            }
        }

        if (aFull && bFull) {
            displayNumA  = sampleCount + 1;
            displayFullA = false;
            displayNumB  = sampleCount + 2;
            displayFullB = false;
            pairSlot[0]  = 0; pairSlot[1] = 1;
            servoIndex   = 0;
            Serial.printf("[RESET] Both full → next pair A=%d B=%d\n",
                displayNumA, displayNumB);
        } else if (aFull && !bFull) {
            int skippedNum = displayNumB;
            displayNumA  = skippedNum;
            displayFullA = false;
            displayNumB  = sampleCount + 2;
            displayFullB = false;
            for (int i = 0; i < 2; i++) {
                if (pairSlot[i]==1) pairSlot[i]=0;
                else                pairSlot[i]=1;
            }
            servoIndex = (pairSlot[0]==0) ? 0 : 1;
            Serial.printf("[RESET] Only A full → promote B#%d to A, new B=%d\n",
                skippedNum, displayNumB);
        } else if (!aFull && bFull) {
            int skippedNum = displayNumA;
            displayNumA  = skippedNum;
            displayFullA = false;
            displayNumB  = sampleCount + 2;
            displayFullB = false;
            pairSlot[0]  = 0; pairSlot[1] = 1;
            servoIndex   = 0;
            Serial.printf("[RESET] Only B full → keep A#%d empty, new B=%d\n",
                skippedNum, displayNumB);
        } else {
            displayFullA = false;
            displayFullB = false;
            servoIndex   = 0;
            Serial.println("[RESET] Neither taken — re-arming same pair");
        }

        sendDisplay();
    }

    // ── LED ───────────────────────────────────
    if (ledGreenOffAt && millis() >= ledGreenOffAt) {
        ledSet(LEDG, false); ledGreenOffAt = 0;
    }
    anyActive = (pairMode[0]>0 || pairMode[1]>0);
    if (anyActive && ledRedOffAt==0 && millis() >= ledFlashNext) {
        ledRedState = !ledRedState;
        ledSet(LEDR, ledRedState);
        ledFlashNext = millis() + LED_FLASH_MS;
    }
    if (ledRedOffAt && millis() >= ledRedOffAt) {
        ledSet(LEDR, false); ledRedOffAt = 0; ledRedState = false;
    }

    // ── Per-pair state machines ────────────────
    for (int i = 0; i < 2; i++) {
        ServoPair& p          = pairs[i];
        unsigned long elapsed = millis() - pairPrevMillis[i];

        switch (pairMode[i]) {

            case 0:
                servoWrite(p.chA, dynSTOP);
                servoWrite(p.chB, dynSTOP);
                break;

            case 1:
                if (!pairModeEntered[i]) {
                    pairModeEntered[i] = true;
                    servoWrite(p.chA, dynOPEN);
                    servoWrite(p.chB, dynOPEN);
                }
                if (elapsed >= MAG_IGNORE_TIME) {
                    if (!pairStoppedA[i] &&
                        (digitalRead(p.reedA)==LOW || elapsed>=MAX_MOVE_TIME)) {
                        pairStoppedA[i] = true;
                        servoWrite(p.chA, dynSTOP);
                        Serial.printf("[SERVO] Pair %d A open — stopped\n", i+1);
                    }
                    if (!pairStoppedB[i] &&
                        (digitalRead(p.reedB)==LOW || elapsed>=MAX_MOVE_TIME)) {
                        pairStoppedB[i] = true;
                        servoWrite(p.chB, dynSTOP);
                        Serial.printf("[SERVO] Pair %d B open — stopped\n", i+1);
                    }
                    if (pairStoppedA[i] && pairStoppedB[i]) {
                        sensors.requestTemperatures();
                        float st = sensors.getTempC(SURFACE_ADDR);
                        float dt = sensors.getTempC(DEPTH_ADDR);
                        if (fabsf(st-85.0f)<0.5f || st==DEVICE_DISCONNECTED_C) st = NAN;
                        if (fabsf(dt-85.0f)<0.5f || dt==DEVICE_DISCONNECTED_C) dt = NAN;
                        Serial.printf("[TEMP] Pair %d S=%.2f D=%.2f\n", i+1,
                            isnan(st)?0.0f:st, isnan(dt)?0.0f:dt);
                        if (pairSnap[i].valid) {
                            writeSDRow(st, dt, i);
                            pairSnap[i].valid = false;
                        }
                        pairPrevMillis[i] = millis();
                        pairMode[i] = 2;
                    }
                }
                break;

            case 2:
                if (elapsed >= PAUSE_TIME) {
                    pairPrevMillis[i] = millis();
                    pairMode[i] = 3;
                }
                break;

            case 3:
                servoWrite(p.chA, dynSTOP);
                servoWrite(p.chB, dynSTOP);
                if (!sentFull[i]) {
                    sentFull[i] = true;
                    if (pairSlot[i]==0) displayFullA = true;
                    else                displayFullB = true;
                    sendDisplay();
                    Serial.printf("[STATE3] Pair %d slot %s now FULL — waiting for reset\n",
                        i+1, pairSlot[i]==0?"A":"B");
                }
                break;

            case 4:
                if (!pairModeEntered[i]) {
                    pairModeEntered[i] = true;
                    servoWrite(p.chA, dynCLOSE);
                    servoWrite(p.chB, dynCLOSE);
                }
                if (elapsed >= MAG_IGNORE_TIME) {
                    if (!pairStoppedA[i] &&
                        (digitalRead(p.reedA)==LOW || elapsed>=MAX_MOVE_TIME)) {
                        pairStoppedA[i] = true;
                        servoWrite(p.chA, dynSTOP);
                        Serial.printf("[SERVO] Pair %d A closed — stopped\n", i+1);
                    }
                    if (!pairStoppedB[i] &&
                        (digitalRead(p.reedB)==LOW || elapsed>=MAX_MOVE_TIME)) {
                        pairStoppedB[i] = true;
                        servoWrite(p.chB, dynSTOP);
                        Serial.printf("[SERVO] Pair %d B closed — stopped\n", i+1);
                    }
                    if (pairStoppedA[i] && pairStoppedB[i]) {
                        pairMode[i] = 0;
                        ledSet(LEDR, true); ledRedState = true;
                        ledRedOffAt  = millis() + 1000;
                        ledFlashNext = 0;
                        Serial.printf("[SERVO] Pair %d cycle complete\n", i+1);
                    }
                }
                break;
        }
    }

    for (int i = 0; i < 2; i++)
        if (pairMode[i] == 0) sentFull[i] = false;
}
